Jonamac/RP2040_CCT_Dimmer/pcb/RP2040_CCT_PWM_Dimmer_V3.kicad_sch

## KiCad design pcb/RP2040_CCT_PWM_Dimmer_V3.kicad_sch (2026-04-04)

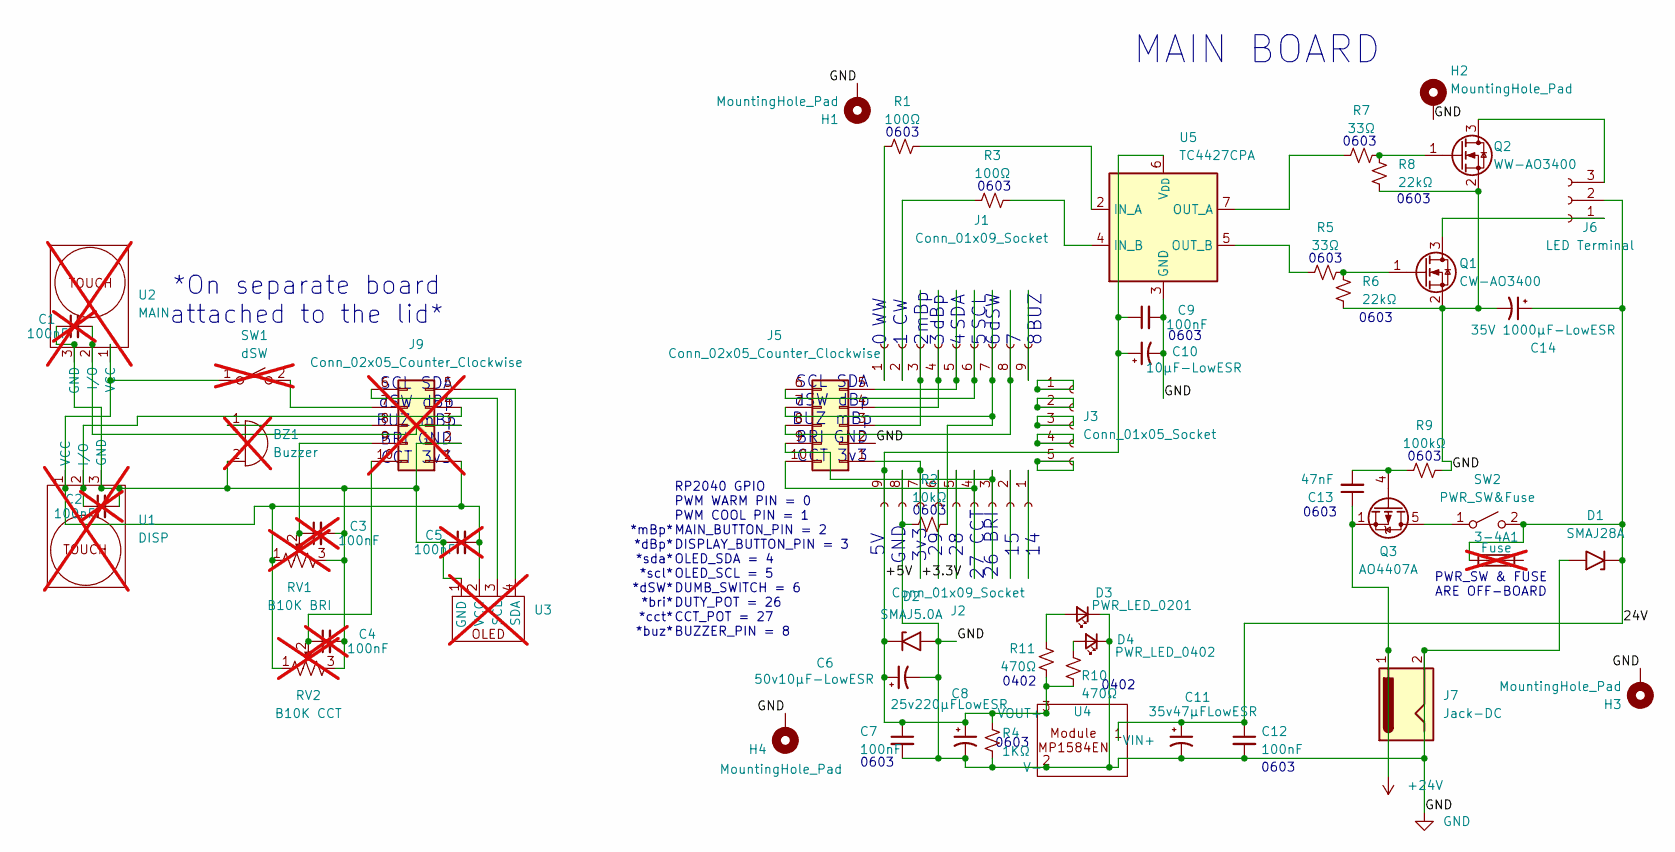
[picture p1: schematic RP2040_CCT_PWM_Dimmer_V3.kicad_sch]

Parts:
3-4A1: Fuse; not fitted
BZ1: Buzzer; not fitted
C1, C2, C3, C4, C5: 100nF; C_1206_3216Metric_Pad1.33x1.80mm_HandSolder; not fitted
C6: 50v10µF-LowESR; CP_5x11mm_horiz-L_P2.5mm
C7, C9, C12: 100nF; C_0603_1608Metric_Pad1.08x0.95mm_HandSolder
C8: 25v220µFLowESR; CP_Radial_D8.0mm_P3.50mm
C10: 10µF-LowESR; CP_Radial_D5.0mm_P2.50mm
C11: 35v47µFLowESR; CP_Radial_D5.0mm_P2.50mm
C13: 47nF; C_0603_1608Metric_Pad1.08x0.95mm_HandSolder
C14: 35V 1000μF-LowESR; CP_Radial_D10.0mm_P5.00mm
D1: SMAJ28A; D_SMA
D2: SMAJ5.0A; D_SMA
D3: PWR_LED_0201; LED_0201_0603Metric_Pad0.64x0.40mm_HandSolder
D4: PWR_LED_0402; LED_0402_1005Metric_Pad0.77x0.64mm_HandSolder
H1, H2, H3, H4: MountingHole_Pad; MountingHole_2.2mm_M2_DIN965__SquarePad
J1: Conn_01x09_Socket; CUSTOM2PinSocket_2x09_P2.54mm_Vertical
J2: Conn_01x09_Socket; CUSTOMGNDPinSocket_2x09_P2.54mm_Vertical
J3: Conn_01x05_Socket; CustomSolderHoleThingsLibraryCUSTOMPinSocket_2x05_P2.54mm_V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
J5: Conn_02x05_Counter_Clockwise; PinHeader_2x05_P2.54mm_Vertical_MIRRORED
J6: LED Terminal; CustomTerminalBlock_MaiXu_MX126-5.0-03P_1x03_P5.00mm
J7: Jack-DC; SolderWire-1sqmm_1x02_P5.4mm_D1.4mm_OD3.9mm
J9: Conn_02x05_Counter_Clockwise; PinHeader_2x05_P2.54mm_Vertical; not fitted
Q1: CW-AO3400; SOT-23_Handsoldering
Q2: WW-AO3400; SOT-23_Handsoldering
Q3: AO4407A; SOIC-8_3.9x4.9mm_P1.27mm
R1, R3: 100Ω; R_0603_1608Metric_Pad0.98x0.95mm_HandSolder
R2: 10kΩ; R_0603_1608Metric_Pad0.98x0.95mm_HandSolder
R4: 1KΩ; R_0603_1608Metric_Pad0.98x0.95mm_HandSolder
R5, R7: 33Ω; R_0603_1608Metric_Pad0.98x0.95mm_HandSolder
R6, R8: 22kΩ; R_0603_1608Metric_Pad0.98x0.95mm_HandSolder
R9: 100kΩ; R_0603_1608Metric_Pad0.98x0.95mm_HandSolder
R10, R11: 470Ω; R_0402_1005Metric_Pad0.72x0.64mm_HandSolder
RV1: B10K BRI; not fitted
RV2: B10K CCT; not fitted
SW1: dSW; not fitted
SW2: PWR_SW&Fuse; SolderWire-1sqmm_1x02_P5.4mm_D1.4mm_OD3.9mm
U1: DISP; not fitted
U2: MAIN; not fitted
U3: not fitted
U4: SRT_MPT1584EN_Module_OFF-BOARD
U5: TC4427CPA; DIP-8_W7.62mm_LongPads

Connections:
24V: 3-4A1.1, C11.1 (+), C12.1, C14.1, D1.1 (A1), J6.2, SW2.2 (B), U4.1 (VIN+)
+3.3V: J2.7, J5.1
+5V: C6.1, C7.1, C8.1, C9.1, C10.1, D2.1 (A1), J2.9, R4.2, R10.1, R11.1, U4.3 (VOUT+), U5.6 (V_{DD})
+24V: C13.1, J7.1, Q3.1 (S), Q3.2 (S), Q3.3 (S)
GND: C6.2, C7.2, C8.2, C9.2, C10.2, C11.2 (-), C12.2, C14.2, D1.2 (A2), D2.2 (A2), D3.1 (K), D4.1 (K), H1.1, H2.1, H3.1, H4.1, J2.8, J5.2, J7.2, Q1.2 (S), Q2.2 (S), R2.2, R4.1, R6.1, R8.2, R9.1, U4.2 (V-), U5.3 (GND)
unnamed: BZ1.1 (+), J9.8
unnamed: BZ1.2 (-), C1.1, C2.2, C3.2, C4.2, C5.1, J9.2, RV1.3, RV2.3, U1.3 (GND), U2.3 (GND), U3.1 (GND)
unnamed: C1.2, J9.3, U2.2 (I/O)
unnamed: C2.1, J9.4, U1.2 (I/O)
unnamed: C3.1, J9.9, RV1.2
unnamed: C4.1, J9.10, RV2.2
unnamed: C5.2, J9.1, RV1.1, RV2.1, SW1.1 (A), U1.1 (VCC), U2.1 (VCC), U3.2 (VCC)
unnamed: C13.2, Q3.4 (G), R9.2
unnamed: D3.2 (A), R11.2
unnamed: D4.2 (A), R10.2
unnamed: J1.1, R1.1
unnamed: J1.2, R3.1
unnamed: J1.3, J5.3
unnamed: J1.4, J5.4
unnamed: J1.5, J5.5
unnamed: J1.6, J5.6
unnamed: J1.7, J5.7, R2.1
unnamed: J1.8, J5.8
unnamed: J2.3, J5.9
unnamed: J2.4, J5.10
unnamed: J6.1, Q1.3 (D)
unnamed: J6.3, Q2.3 (D)
unnamed: J9.5, U3.4 (SDA)
unnamed: J9.6, U3.3 (SCL)
unnamed: J9.7, SW1.2 (B)
unnamed: Q1.1 (G), R5.2, R6.2
unnamed: Q2.1 (G), R7.2, R8.1
unnamed: Q3.5 (D), Q3.6 (D), Q3.7 (D), Q3.8 (D), SW2.1 (A)
unnamed: R1.2, U5.2 (IN_A)
unnamed: R3.2, U5.4 (IN_B)
unnamed: R5.1, U5.5 (OUT_B)
unnamed: R7.1, U5.7 (OUT_A)

Notes on the sheet:
0603
MAIN BOARD
5V GND 3v3
26 BRI 15 14
3 4 5
SCL SDA dSW dBp BUZ mBp BRI GND CCT 3v3
dBp SDA SCL
0402
dSW BUZ
*mBp* *dBp* *sda* *scl* *dSW* *bri* *cct* *buz*
RP2040 GPIO PWM WARM PIN = 0 PWM COOL PIN = 1 MAIN_BUTTON_PIN = 2 DISPLAY_BUTTON_PIN = 3 OLED_SDA = 4 OLED_SCL = 5 DUMB_SWITCH = 6 DUTY_POT = 26 CCT_POT = 27 BUZZER_PIN = 8
6 7 8
0 1 2
29 28 27 CCT
WW CW mBp
PWR_SW & FUSE ARE OFF-BOARD
*On separate board attached to the lid*
