Jonamac/RP2040_CCT_Dimmer/src/RP2040_CCT_Dimmer.cpp

#ifndef RP2040_CCT_DIMMER_CPP
#define RP2040_CCT_DIMMER_CPP

#include <Arduino.h>
#include "pins.h"
#include "state.h"
#include "pwm_control.h"
#include "buzzer.h"
#include "inputs.h"
#include "pots.h"
#include "ledmix.h"
#include "display_ui.h"
#include "modes.h"
#include "timing.h"
#include "freq_mode.h"
#include "calibration.h"

void setup() {
    // Force PWM outputs low immediately — prevents any brief flash at power-on
    // before the PWM hardware is properly initialized
    pinMode(WARM_PIN, OUTPUT);
    digitalWrite(WARM_PIN, LOW);
    pinMode(COOL_PIN, OUTPUT);
    digitalWrite(COOL_PIN, LOW);

    Serial.begin(115200);
    analogReadResolution(12);

    initPins();
    initPWM();
    analogWrite(WARM_PIN, 0);
    analogWrite(COOL_PIN, 0);
    initBuzzer();
    initDisplay();
    initTiming();
    initModes();

    pinMode(DUMB_SWITCH_PIN, INPUT_PULLDOWN);

    unsigned long now = millis();

    // -------------------------------------------------------
    //  CHECK DUMB MODE *BEFORE* ANYTHING ELSE
    // -------------------------------------------------------
    bool dumbAtBoot = digitalRead(DUMB_SWITCH_PIN);

    if (dumbAtBoot) {
        // Set mode immediately so all subsequent logic is correct
        currentMode = MODE_DUMB;

        buzzer_click_enabled = false;
        buzzer_beep_enabled  = false;

        // Allow ADC input capacitance and voltage reference to settle after power-on.
        delay(500);

        // Average 32 readings for stable boot-time pot values
        // (single samples are too noisy at 12-bit resolution)
        int dutySum = 0, cctSum = 0;
        for (int i = 0; i < 32; i++) {
            dutySum += analogRead(DUTY_POT_PIN);
            cctSum  += analogRead(CCT_POT_PIN);
        }
        int rawDutyADC = dutySum / 32;
        int rawCCTADC  = cctSum  / 32;
        Serial.print("Boot ADC — DUTY raw: "); Serial.print(rawDutyADC);
        Serial.print(" | CCT raw: "); Serial.println(rawCCTADC);

        float dutyNorm = constrain(
            (rawDutyADC - DUTY_MIN_RAW) / float(DUTY_MAX_RAW - DUTY_MIN_RAW),
            0.0f, 1.0f);
        float endB = min_duty + dutyNorm * (1.0f - min_duty);

        float cctNorm = constrain(
            (rawCCTADC - CCT_MIN_RAW) / float(CCT_MAX_RAW - CCT_MIN_RAW),
            0.0f, 1.0f);
        float startCCT = 2700.0f + cctNorm * (6500.0f - 2700.0f);

        // Apply initial state (LEDs off, CCT set)
        ledmix_set(0.0f, startCCT);
        applyLEDsImmediate(0.0f, startCCT);
        ledmix_initCurrent();

        // Start async DUMB boot fade
        // Use a fresh millis() here — `now` was captured before delay(500) and
        // ADC reads, so it is already ~500 ms stale. Using `now` would make
        // elapsed ≥ dumb_soft_start_ms on the very first loop() tick, causing
        // the fade to complete instantly with no visible soft-start.
        dumbFadeActive    = true;
        dumbFadeDirection = true;
        dumbFadeStartB    = 0.0f;
        dumbFadeEndB      = endB;
        dumbFadeStartTime = millis();
        dumbFadeDuration  = dumb_soft_start_ms;
        bootFadeActive    = true;

        // systemInitialized set by updateLEDLogic when dumbFade completes
        return;
    }

    // -------------------------------------------------------
    //  NORMAL BOOT — async soft start
    // -------------------------------------------------------
    buzzer_click_enabled = false;
    buzzer_beep_enabled  = true;

    // Read DUTY ADC now — brightness step doesn't require ADC settling
    int dutySum = 0;
    for (int i = 0; i < 32; i++) dutySum += analogRead(DUTY_POT_PIN);
    int rawDutyADC = dutySum / 32;

    float dutyNorm = constrain(
        (rawDutyADC - DUTY_MIN_RAW) / float(DUTY_MAX_RAW - DUTY_MIN_RAW),
        0.0f, 1.0f);
    int idx = constrain((int)round(dutyNorm * (NORMAL_STEPS - 1)), 0, NORMAL_STEPS - 1);
    float targetB = normalBrightnessSteps[idx];

    // Apply initial state (LEDs off, default CCT) — CCT will be updated below
    ledmix_set(0.0f, 4600.0f);
    applyLEDsImmediate(0.0f, 4600.0f);
    ledmix_initCurrent();

    // Fire startup beep BEFORE reading CCT ADC.
    // buzzerStartupBeep() is blocking (~200–400ms) — this gives the RP2040 ADC
    // input capacitor and voltage reference time to fully settle at operating
    // temperature. Reading CCT after the beep produces the same value that
    // syncPotsAfterBoot() will read at fade-end, eliminating the CCT mismatch
    // that causes the visible snap.
    buzzerStartupBeep();

    // Now read CCT ADC — ADC has settled during the beep
    int cctSum = 0;
    for (int i = 0; i < 32; i++) cctSum += analogRead(CCT_POT_PIN);
    int rawCCTADC = cctSum / 32;

    float cctNorm = constrain(
        (rawCCTADC - CCT_MIN_RAW) / float(CCT_MAX_RAW - CCT_MIN_RAW),
        0.0f, 1.0f);
    int stepIdx = constrain((int)round(cctNorm * 38.0f), 0, 38);
    float startCCT = 2700.0f + stepIdx * 100.0f;

    Serial.print("Boot ADC — DUTY raw: "); Serial.print(rawDutyADC);
    Serial.print(" | CCT raw (post-beep): "); Serial.print(rawCCTADC);
    Serial.print(" → stepIdx: "); Serial.print(stepIdx);
    Serial.print(" → startCCT: "); Serial.println(startCCT);

    // Update ledmix with the settled CCT before starting the fade
    ledmix_set(0.0f, startCCT);
    ledmix_initCurrent();

    // Start async NORMAL boot fade
    normalFadeActive    = true;
    normalFadeStartB    = 0.0f;
    normalFadeEndB      = targetB;
    normalFadeStartTime = millis();
    normalFadeDuration  = soft_start_ms;
    bootFadeActive      = true;

    // systemInitialized and buzzer_click_enabled set by updateLEDLogic when fade completes
}

void loop() {
  unsigned long now = millis();

  readInputs(now);          // pots + buttons + buzzer toggles
  updateModeState(now);     // state machine transitions
  updateModeBehavior(now);  // per-mode behavior (demo, standby, etc.)
  updateLEDLogic(now);      // gamma, min duty, fades, LED update delay
  updateDisplayLogic(now);  // text, bars, flashing, timeout
}

#endif // RP2040_CCT_DIMMER_CPP
