Jonamac/RP2040_CCT_Dimmer/RP2040_CCT_Dimmer-LED_DRIVER_ANALYZER/pwm_control.h

#pragma once
#include <Arduino.h>

void initPWM();
void setPwmRange(int range);  // keep in sync with analogWriteRange()
void setWarmDuty(float duty); // 0.0–1.0
void setCoolDuty(float duty); // 0.0–1.0
