Jonamac/RP2040_CCT_Dimmer/include/pwm_control.h

#ifndef PWM_CONTROL_H
#define PWM_CONTROL_H

#include <Arduino.h>
#include "pins.h"

extern float currentWarmDuty;
extern float currentCoolDuty;

void initPWM();
void setWarmDuty(float duty); // 0.0–1.0
void setCoolDuty(float duty); // 0.0–1.0

#endif // PWM_CONTROL_H
