Jonamac/RP2040_CCT_Dimmer/include/buzzer.h

#ifndef BUZZER_H
#define BUZZER_H

#include <Arduino.h>
#include "pins.h"
#include "state.h"

void initBuzzer();
void buzzerClick();
void buzzerLEDUpdateBeep();
void buzzerModeChangeBeep();
void buzzerStartupBeep();
void handleBuzzerToggle(unsigned long now, bool mainPressed, bool dispPressed);

#endif // BUZZER_H
