Jonamac/RP2040_CCT_Dimmer/include/inputs.h

#ifndef INPUTS_H
#define INPUTS_H

#include <Arduino.h>

int readADC(int pin);

void readInputs(unsigned long now);
void processButtons(unsigned long now);
// Reset DEMO brightness tracking so it re-evaluates the pot
void resetDemoBrightnessTracking();

#endif // INPUTS_H
