Jonamac/RP2040_CCT_Dimmer/src/brightness_table.cpp

#ifndef BRIGHTNESS_TABLE_CPP
#define BRIGHTNESS_TABLE_CPP

#include "brightness_table.h"

const float brightnessTable[BRIGHTNESS_STEPS] = {
    0.0000, 0.0001, 0.0003, 0.0006, 0.0010, 0.0016, 0.0023, 0.0032, 0.0042, 0.0054,
    0.0068, 0.0083, 0.0100, 0.0119, 0.0139, 0.0161, 0.0185, 0.0211, 0.0239, 0.0269,
    0.0301, 0.0335, 0.0371, 0.0409, 0.0449, 0.0491, 0.0535, 0.0581, 0.0629, 0.0679,
    0.0731, 0.0785, 0.0841, 0.0899, 0.0959, 0.1021, 0.1085, 0.1151, 0.1219, 0.1289,
    0.1361, 0.1435, 0.1511, 0.1589, 0.1669, 0.1751, 0.1835, 0.1921, 0.2009, 0.2099,
    0.2191, 0.2285, 0.2381, 0.2479, 0.2579, 0.2681, 0.2785, 0.2891, 0.2999, 0.3109,
    0.3221, 0.3335, 0.3451, 0.3569, 0.3689, 0.3811, 0.3935, 0.4061, 0.4189, 0.4319,
    0.4451, 0.4585, 0.4721, 0.4859, 0.4999, 0.5141, 0.5285, 0.5431, 0.5579, 0.5729,
    0.5881, 0.6035, 0.6191, 0.6349, 0.6509, 0.6671, 0.6835, 0.7001, 0.7169, 0.7339,
    0.7511, 0.7685, 0.7861, 0.8039, 0.8219, 0.8401, 0.8585, 0.8771, 0.8959, 0.9149,
    0.9341
};

#endif // BRIGHTNESS_TABLE_CPP
