Jonamac/RP2040_CCT_Dimmer/src/freq_mode.cpp

// freq_mode.cpp
#ifndef FREQ_MODE_CPP
#define FREQ_MODE_CPP

#include "freq_mode.h"

int freqModeIndex = 0;   // global index
float freqStrobeHz = 1.0f;  // global frequency used by strobe engine

void freqModeSetIndex(int idx) {
    if (idx < 0) idx = 0;
    if (idx >= FREQ_STEPS) idx = FREQ_STEPS - 1;

    freqModeIndex = idx;
    freqStrobeHz = freqTable[idx];
}

const int FREQ_STEPS = 35;

const float freqTable[FREQ_STEPS] = {
    1.0f,
    1.5f,
    2.0f,
    2.5f,
    5.0f,
    7.5f,
    10.0f,
    11.988f,
    12.5f,
    14.985f,
    15.0f,
    20.0f,
    23.976f,
    24.0f,
    25.0f,
    29.97f,
    30.0f,
    35.0f,
    40.0f,
    45.0f,
    50.0f,
    55.0f,
    59.94f,
    60.0f,
    65.0f,
    70.0f,
    75.0f,
    80.0f,
    85.0f,
    90.0f,
    95.0f,
    100.0f,
    110.0f,
    119.88f,
    120.0f
};

#endif // FREQ_MODE_CPP
