Jonamac/RP2040_CCT_Dimmer/(commit log)

2026-03-08 Initial file upload
    Current state is functional, but very buggy
    [RP2040_CCT_Dimmer.ino, RP2040_CCT_Dimmer_POT_CALIBRATION_TEST.ino, buttons.cpp, buzzer.cpp, buzzer.h, calibration.cpp, calibration.h, display_ui.h]
2026-03-08 Phase 2: Renamed OVERRIDE → FREQ and OVERRIDE+ → CAL
2026-03-08 Phase 3: Implement full FREQ mode (strobe engine, pot routing, display, brightness table)
    - Added incomplete FREQ mode with strobe engine and frequency selection
    - Implemented perceptual brightness lookup table (gamma-corrected)
    - Added brightness_table.h/.cpp module
    - Added freqStrobeHz state and strobe timing variables
    - Updated pot routing for FREQ mode (brightness + frequency index)
    - Updated OLED UI to show frequency with 3 decimals
    - Added mode transitions for NORMAL <-> FREQ and STANDBY return
    - Cleaned up inputs.h and inputs.cpp (ADC variable declarations)
    - Ensured no interference with NORMAL, DUMB, DEMO, or CAL modes
    [brightness_table.cpp, brightness_table.h, displayui.cpp, inputs.cpp, inputs.h, ledmix.cpp, ledmix.h, modes.cpp]
2026-03-09 Rewrite pots.cpp into strict mode‑exclusive architecture; remove obsolete OVERRIDE logic
    - Replaced legacy pots.cpp with a fully deterministic, mode‑exclusive pot engine
    - Eliminated all fall‑through and cross‑mode overwrites
    - Unified NORMAL mode into a single brightness+CCT block
    - Implemented clean, isolated blocks for DUMB, NORMAL, DEMO, FREQ, CAL, and STANDBY
    - Removed obsolete OVERRIDE/OVERRIDE+ brightness logic
    - Removed global pot‑tracking variables; replaced with local static state
    - Removed resetDemoBrightnessTracking() and other legacy dependencies
    - Fixed CCT flicker, brightness snap‑back, and 50% duty cap
    - Ensured FREQ mode brightness/frequency updates are isolated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
    [displayui.cpp, modes.cpp, modes.h, pots.cpp, state.cpp, state.h]
2026-04-04 Added KiCad PCB and Schematic files
    [RP2040_CCT_PWM_Dimmer_V3.kicad_sch]
2026-04-16 Refactor DUMB mode button handling and isolate mode transitions
    - Added dedicated DUMB-mode MAIN button logic (instant toggle, no DJI timing)
    - Moved DUMB standby enter/exit logic into modes.cpp (handleDumbToggle)
    - Removed accidental calls to handleMainButtonRelease() from DUMB mode
    - Fixed structural issues in buttons.cpp (function nesting, missing braces)
    - Cleaned up DUMB mode behavior to prevent mode flips and double beeps
    - Updated display to use targetBrightness for DUTY% and physical PWM for mDUTY
    - Prepared codebase for next phase: startup stabilization, mDUTY tightening,
    NORMAL step-0 min_duty behavior, brightness table rebuild, and buzzer restore
    This commit stabilizes DUMB mod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
    [RP2040_CCT_Dimmer.ino, RP2040_CCT_Dimmer_POT_CALIBRATION_TEST.ino, calibration.cpp, display_ui.h, displayui.cpp, freq_mode.cpp, freq_mode.h, inputs.cpp]
2026-04-16 Add firmware and state machine specs
    Add two new documentation files: docs/firmware_spec.md and docs/state_machine.md. The firmware spec describes file responsibilities, data flow, fade engine architecture (NORMAL/DUMB/boot), brightness table behavior, DUMB mode semantics, startup and buzzer behavior, and display/UI responsibilities. The state machine spec defines authoritative mode behavior, transition rules, fade rules, brightness/CCT handling, display and button rules, DUMB switch debouncing/startup lockout, and system initialization steps. These docs serve as the reference for firmware implementation and mode semantics.
2026-04-16 PR 1: Fix DUMB mode silent failures in inputs.cpp, pots.cpp, and inputs.h
    Agent-Logs-Url: https://github.com/Jonamac/RP2040_CCT_Dimmer/sessions/ef3c5cc0-147a-477d-bb0f-9afdaa5315dd
    [inputs.cpp, inputs.h, pots.cpp]
2026-04-16 PR 3: Core architecture fix — async boot, DUMB mode assignment, NORMAL fade engine
    Agent-Logs-Url: https://github.com/Jonamac/RP2040_CCT_Dimmer/sessions/0cead013-8fa7-4ed6-806f-2b141b3dbef4
    [RP2040_CCT_Dimmer.ino, ledmix.cpp, modes.cpp, pots.cpp, state.cpp, state.h]
2026-04-16 hotfix: replace DUTY_PHYSICAL_MIN/MAX block with ledmix_getBrightness() * 100
    Agent-Logs-Url: https://github.com/Jonamac/RP2040_CCT_Dimmer/sessions/126b8ce4-e44c-4e41-a96d-83cdd5b644ac
    [displayui.cpp]
2026-04-16 Hotfix: boot double-fade, fade-up snap, DUMB jitter
    Agent-Logs-Url: https://github.com/Jonamac/RP2040_CCT_Dimmer/sessions/ca983dbf-9177-4e44-851f-714791f06b5e
    [ledmix.cpp, modes.cpp, pots.cpp]
2026-04-16 Hotfix: DUMB display range, DUMB pot extremes, NORMAL boot snap
    Agent-Logs-Url: https://github.com/Jonamac/RP2040_CCT_Dimmer/sessions/436725d8-414e-4492-8f0b-3acb629dfa63
    [RP2040_CCT_Dimmer.ino, displayui.cpp, pots.cpp, pots.h]
2026-04-16 fix: four-bug hotfix — DUMB display floor, STANDBY switch, DUMB PWM min, NORMAL boot CCT snap
    Agent-Logs-Url: https://github.com/Jonamac/RP2040_CCT_Dimmer/sessions/a16ad0b7-09c2-43f1-abc4-86c4195711a4
    [RP2040_CCT_Dimmer.ino, displayui.cpp, ledmix.cpp, ledmix.h, modes.cpp, pots.cpp, pots.h]
2026-04-17 Hotfix: boot CCT snap, DUMB buzzer, DUMB jitter, DUMB minimum, standby flash, step click
    Agent-Logs-Url: https://github.com/Jonamac/RP2040_CCT_Dimmer/sessions/cf2e383e-9354-45b0-a5c9-cfc66624145b
    [modes.cpp, pots.cpp]
2026-04-17 Hotfix: 16-sample boot ADC, Schmitt trigger steps, remove DUMB snap zone, CCT click
    Agent-Logs-Url: https://github.com/Jonamac/RP2040_CCT_Dimmer/sessions/db41f338-10f7-4510-b9b9-4824d47929fc
    [RP2040_CCT_Dimmer.ino, pots.cpp]
2026-04-17 fix: boot snap, pot filter lag, DUMB display, NORMAL→DUMB/DUMB→NORMAL transitions
    Agent-Logs-Url: https://github.com/Jonamac/RP2040_CCT_Dimmer/sessions/012753ba-a210-4b33-9bb0-3c0b8c5b60de
    [displayui.cpp, modes.cpp, pots.cpp, pots.h]
2026-04-17 fix: use float division (8.0f) for ADC averaging to avoid integer truncation
    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
    [modes.cpp]
2026-04-17 Fix NORMAL boot CCT/brightness snap and DUMB mode filter cascade lag
    Agent-Logs-Url: https://github.com/Jonamac/RP2040_CCT_Dimmer/sessions/d853c9a7-4479-470a-9526-32d10ff1c288
    [pots.cpp]
2026-04-17 Fix four bugs: NORMAL boot CCT snap, DUMB gamma/display, display layout, DUMB idle jitter
    Agent-Logs-Url: https://github.com/Jonamac/RP2040_CCT_Dimmer/sessions/453d48f5-96b7-4e17-afd5-4bc0942677fe
    [RP2040_CCT_Dimmer.ino, displayui.cpp, ledmix.cpp, pots.cpp]
2026-04-17 Fix ADC settle time, DUMB endpoint snaps, CCT center snap, display resolution, idle jitter
    Agent-Logs-Url: https://github.com/Jonamac/RP2040_CCT_Dimmer/sessions/b6fe0c70-75b9-4035-abd5-779bb245b8a2
    [RP2040_CCT_Dimmer.ino, displayui.cpp, pots.cpp]
2026-04-17 Fix boot CCT snap, pre-startup flash, DUMB endpoint snap zones, DUMB DUTY display, mDUTY label
    Agent-Logs-Url: https://github.com/Jonamac/RP2040_CCT_Dimmer/sessions/4ae4f30d-4a31-48bd-8c60-049dacfa8af1
    [RP2040_CCT_Dimmer.ino, displayui.cpp, ledmix.cpp, pots.cpp]
2026-04-17 Multi-file hotfix: boot CCT snap, DUMB gamma, NORMAL jitter, display layout fixes
    Agent-Logs-Url: https://github.com/Jonamac/RP2040_CCT_Dimmer/sessions/5cad5704-cab4-400c-99b6-f1c59f79300a
    [displayui.cpp, ledmix.cpp, pots.cpp]
2026-04-17 Fix boot CCT snap: replace syncPotsAfterBoot body with definitive invariant version; update AI_NOTES.md
    Agent-Logs-Url: https://github.com/Jonamac/RP2040_CCT_Dimmer/sessions/bd7efe0a-b278-422b-9332-218f757df2c5
    [pots.cpp]
2026-04-17 fix: read CCT ADC after buzzerStartupBeep() for settled boot CCT value
    Agent-Logs-Url: https://github.com/Jonamac/RP2040_CCT_Dimmer/sessions/6ef52890-5365-43d7-bebb-1ace457860db
    [RP2040_CCT_Dimmer.ino]
2026-04-19 Fix DUMB gamma, startup fade, and pot reseed
    Fix DUMB mode gamma handling, correct startup fade timing, and reseed pot filter on standby exit.
    In DUMB mode the generic gamma scale was being applied even for B_linear <= min_duty, which crushed channel duties below the hardware minimum. The code now applies gamma only to the normalized range above min_duty and uses a linear 0→min_duty fade region so pot-minimum maps to the hardware minimum and standby fades remain visible. applyLEDsImmediate now computes and sets channel duties directly and returns early in DUMB mode.
    Also replaced a stale `now` timestamp with `millis()` when starting the async DUMB boot fade so the soft-start doesn't comp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
    [RP2040_CCT_Dimmer.cpp, ledmix.cpp, modes.cpp]
2026-04-19 Add RP2040 LED driver analyzer sketch, FIX min_duty
    Add a standalone RP2040 CCT dimmer / LED driver analyzer project and adjust global state. New RP2040_CCT_Dimmer-LED_DRIVER_ANALYZER/* files include the main .ino, calibration data/header, PWM control module, display stub (SSD1306), pins header, PlatformIO config, .gitignore and a VS Code workspace. The sketch implements ADC smoothing, gamma correction, CCT preset snapping, pot/button stepping, PWM range switching and an OLED diagnostic UI. Also update src/state.cpp to lower min_duty to 0.000244f (per-channel minimum = RAW 1/4095) to match the new analyzer's resolution.
    [RP2040_CCT_Dimmer-LED_DRIVER_ANALYZER.ino, calibration.cpp, calibration.h, display_stub.cpp, display_stub.h, pins.h, pwm_control.cpp]
2026-04-20 PR 6: NORMAL: step0=min_duty; display & mixing fixes
    Make NORMAL mode step 0 equal the calibrated hardware min_duty and bake perceptual gamma into the NORMAL table. Rebuild normalBrightnessSteps (22 entries) and add normalDisplayPercent for OLED cosmetic percentages (step 0 = 0.01%, steps 1–21 = 5–100%). Retire the software effective_off_threshold and adjust applyLEDsImmediate to treat DUMB as the only gamma path, use min_duty as the mixing floor, and scale both channels 0→min_duty when brightness is below the combined channel floor. Expose normalDisplayPercent in calibration.h and add pots_getNormalDutyStep() to pots.h/src so displayui can show the cosmetic percent for NORMAL. Silence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
    [calibration.cpp, calibration.h, displayui.cpp, ledmix.cpp, modes.cpp, pots.cpp, pots.h]
2026-04-20 Refine DUMB mode smoothing, display & snaps
    Tweak DUMB-mode behavior and OLED cosmetics:
    - Replace NORMAL-mode cosmetic percent table: step 0 = 0.01%, steps 1–21 = 1%,5%,10%,15%...95%,100% for a more intuitive knob progression.
    - Add DUMB_IIR_MOVE_THOLD = 0.015 and use it to switch adaptive IIR alpha (0.40 moving / 0.05 settled), raising the motion threshold above RP2040 ADC noise to avoid spurious fast-alpha triggers.
    - Reduce DUMB CCT center snap tolerance from ±75K to ±50K (snap between 4550K–4650K).
    - Make brightness and CCT updates independent in handlePots so a CCT change cannot smuggle noisy duty values past the brightness dead-band; only the changed quantity is committed while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
    [calibration.cpp, pots.cpp]
